cedarlakeinstruments/ArduinoTempLogger/DOC/WP_20180820_15_12_12_Pro.jpg

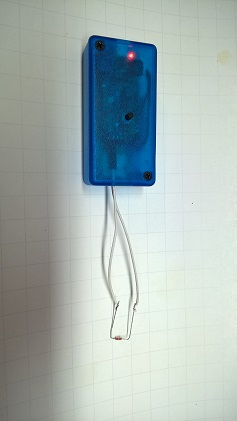
DOC/WP_20180820_15_12_12_Pro.jpg
