cedarlakeinstruments/ArduinoTempLogger/DOC/logger.jpg

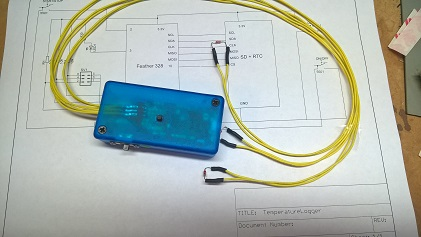
DOC/logger.jpg
