cedarlakeinstruments/ArduinoTempLogger/DOC/Arduino Temperature Sensor.rtf

Overview / Problem Statement

I am developing a garment with specific insulative properties, I need a way to measure the internal temperature of the garment (eg: skin temperature) so that we can adjust the level of insulation within the garment.

I will place temperature probes in a few places in the garment, and then have my testers do various activities in the garment, and the arduino will capture the temperature over time.

Device Requirements
• Arduino device
• Device should be enclosed somehow (device will be in a pocket)
• Battery powered (1 to 3 hour battery life ideally)
• 3x wired (1.5 foot) temperature probes
• Ability to toggle recording on off - alternatively, ability to power device on/off and have device auto capture temperatures
• Indicator LED to verify recording
• Capturing of temperature probe output at a regular cadence (15 seconds, 30 seconds, 1 minute, is sufficient) with timestamp (no preference on format… epoch would be fine, alternatively “incrementing seconds post toggle” also fine , example format:
• Timestamp, Probe, Temperature
• 1533925610, 1, 50
• 1533925640, 1, 50
• 1533925680, 1, 60
• Output of temperature probe readings to file format (eg: CSV)
• Ability to get the temperature readings off the device - (eg: SD card)
• Luxury: ability to connect to device with computer and see live temperature recordings
•
• Other Requirements
• Depending on cost of hardware: would like between 1 and 4 devices
• Device must come with basic documentation on how to use
• Device code must have basic documentation
•
