cedarlakeinstruments/ArduinoTempLogger/DOC/WP_20180820_12_33_00_Pro.jpg

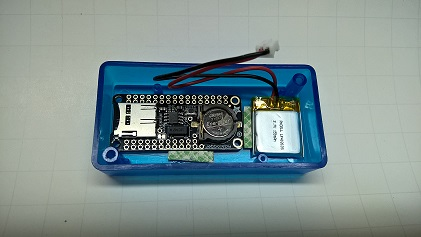
DOC/WP_20180820_12_33_00_Pro.jpg
