cedarlakeinstruments/ArduinoTempLogger/CAD/TemperatureLogger.sch

## EAGLE design CAD/TemperatureLogger.sch (2018-08-31)

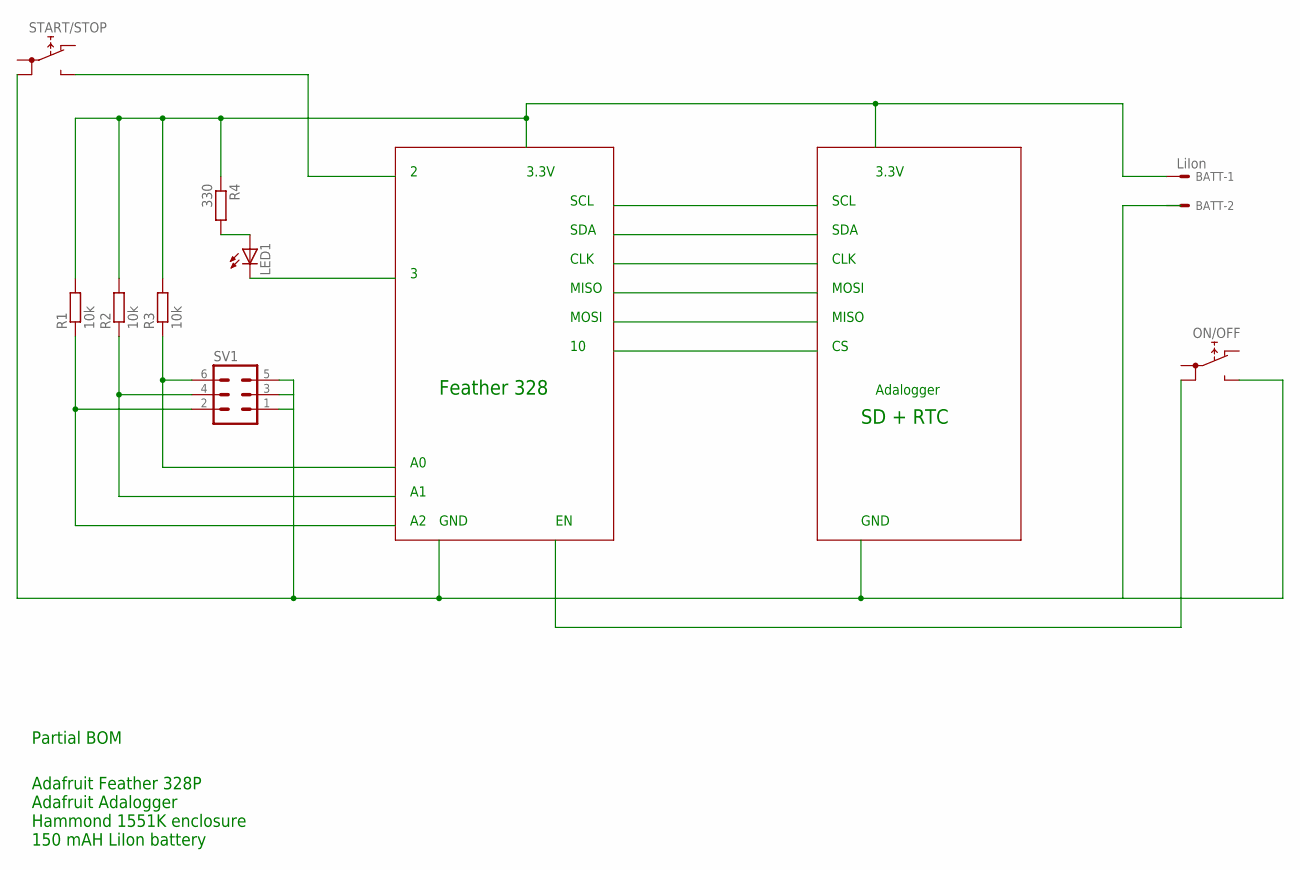
[picture p4: schematic TemperatureLogger.sch]

Parts:
BATT: LiIon; 22-23-2021
LED1: LED; SMARTLED-TTW
ON/OFF: 5501
R1, R2, R3: 10k; M0805
R4: 330; M0805
START/STOP: 5501
SV1: MA03-2

Connections:
unnamed: R3.1, SV1.6
unnamed: R2.1, SV1.4
unnamed: R1.1, SV1.2
unnamed: ON/OFF.NO, START/STOP.1B, SV1.1, SV1.3, SV1.5
unnamed: LED1.A@1 (A), R4.2
unnamed: BATT.1, R1.2, R2.2, R3.2, R4.1

Notes on the sheet:
3.3V
GND
Feather 328
SD + RTC
SCL
SDA
CLK
MOSI
MISO
Adafruit Feather 328P Adafruit Adalogger Hammond 1551K enclosure 150 mAH LiIon battery
Partial BOM
Adalogger
