cedarlakeinstruments/ArduinoTempLogger/DOC/Instructions.rtf

Temperature Logger Instructions

• Turn on power by sliding the On/Off switch to the On position marked by a green dot.
• After a few seconds of self-checking, the red operating LED will blink at a rate of one flash approximately every five seconds to indicate that it is operating.
• To start logging temperature to the SD card, press and release the black pushbutton. The red LED will stay on for a moment to indicate the command was received. Logging will start at the next five second interval and the flash rate will change to two flashes every five seconds to indicate that data is being recorded. The data is recorded in the following format: "HH:MM:SS,T1,T2,T3" where HH:MM:SS is the time of day and T1, T2 and T2 are the temperature readings of the sensors in degrees Celsius.
• To stop logging, press the button again and the flash rate will return to once every five seconds. Be sure to stop logging before turning power off as the SD card data may be corrupted otherwise.

To remove/insert the SD card, gently push it in with the tip of a pencil or ball-point pen until it clicks.

To charge the battery, connect to a USB charger or PC USB port. The yellow Charge LED will illuminate to indicate that the battery is being charged. This indicator stays on even if the device is turned off.
The battery should have several hours of data recording on a single charge.

When plugged into a PC, the logger will also send data directly to the USB port. The yellow Transmit LED will flash every time a data packet is sent to the PC.
The logger will show up on a "virtual COM port" on the PC. The PC device manager can be used to view the ports to identify which one the logger is connected to. A free serial terminal program such as putty.exe can be used to view and save the serial data.
