cedarlakeinstruments/ArduinoTempLogger/Firmware/TemperatureLogger/Thermistor-103J-G1J.h

#pragma once
// This is the resistance table for the 103J-G1J thermistor
// it goes from -80 to 300C in 1C intervals
//
#include <avr/pgmspace.h>
const float TempToOhms[] PROGMEM =
{
	// Resistance from -80C to +300C
	7389000.00,
	6757530.00,
	6184463.00,
	5664013.00,
	5190990.00,
	4760763.00,
	4369173.00,
	4012500.00,
	3687397.00,
	3390863.00,
	3120207.00,
	2872997.00,
	2647053.00,
	2440407.00,
	2251290.00,
	2078100.00,
	1919397.00,
	1773873.00,
	1640357.00,
	1517777.00,
	1405170.00,
	1301663.00,
	1206463.00,
	1118853.00,
	1038180.00,
	963849.00,
	895332.00,
	832130.00,
	773799.00,
	719934.00,
	670166.00,
	624159.00,
	581605.00,
	542225.00,
	505763.00,
	471985.00,
	440674.00,
	411640.00,
	384703.00,
	359700.00,
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
};
