cedarlakeinstruments/ArduinoTempLogger/(commit log)

2018-08-21 Initial commit
    Temperature log to SD card with Arduino
2018-08-31 Added drawing
    Added schematic
    Added ability to set time when programming
    [TemperatureLogger.sch]
